tseary/BC-Matrix_Tetris_v1/README.md

# BC-Matrix_Tetris_v1
An Arduino tetris game for the Boldport Club Matrix
