tseary/BC-Matrix_Tetris_v1/(threads)

Thread 1 (2019-09-02):

High Score sound plays at power-on

tseary, 2019-09-02:
It's not a bug, it's a feature! Change it so that a power-on tune plays instead.

tseary, 2019-09-04:
This issue is worse now that pause has been implemented - the high score sound sometimes plays twice at power on.

tseary, 2019-09-05:
Magically fixed itself in pause branch.

Closed 2019-09-05.

Thread 2 (2019-09-02):

Game Over sound plays when turning sound on

tseary, 2019-09-02:
Following these steps:
1. Turn off sound by resetting with down button pressed
2. Play a game to the end until the screen fills
3. Turn on sound by resetting with down button released
Now the game-over sound plays inappropriately, because the sound controller was not reset.

tseary, 2019-09-04:
Possible solution: when "sound on" command is received, set the track to 0.

tseary, 2019-09-05:
Fixed.

Closed 2019-09-05.

Thread 4 (2019-09-02):

Pause

tseary, 2019-09-02:
Implement pause/unpause when the encoder button is clicked. Also requires pausing the music.

tseary, 2019-09-04:
Essential functionality is working: game and music stops while paused. Music continues where it left off when unpausing. Music restarts if game is reset while paused.
Remaining work is to add a pause screen.

tseary, 2019-09-05:
Completed. Game can now be paused by clicking the encoder button.

tseary, 2019-09-05:
There is no pause screen - that feature will not be implemented for now.

Closed 2019-09-05.

Thread 6 (2019-09-03):

Sound off doesn't work at power on

tseary, 2019-09-03:
To turn off sound, the the user currently has to power on, then hold down and press the reset button. It should be possible to power on with the down button held to turn off sound.

tseary, 2019-09-05:
Magically fixed itself in pause branch.

Closed 2019-09-05.

Thread 9 (2019-09-04):

Switch debouncing

tseary, 2019-09-04:
Switches have become less reliable with use and now require software debouncing. Perhaps need to throttle game loop.

tseary, 2019-09-05:
Fixed by adding 100 us delay in game loop.

Closed 2019-09-05.

Thread 10 (2019-12-10):

No ICSP header on controller

tseary, 2019-12-10:
Last time I had to solder bodge wires onto the microcontroller to bootload it. Never again!

Thread 13 (2019-12-18):

Serial interface

tseary, 2019-12-18:
Add a startup button code to enable serial (maybe by holding the encoder button).
Serial interface features should include setting the pixel brightness EEPROM.

tseary, 2021-06-19:
Startup button code has been implemented.

Thread 21 (2020-02-20):

Swap blocks

tseary, 2020-02-20:
Allow the user to save one block at a time, and swap it out with the current piece.

tseary, 2020-02-28:
It works!

Closed 2020-02-28.

Thread 26 (2021-05-14):

Down button bounce

tseary, 2021-05-14:
When the hardware down button bounces, after dropping one piece the next piece also drops. This is prevented in the software but it is not resilient to switch bounce. Add latency when releasing the switch before allowing the next piece to drop.

tseary, 2021-05-15:
Fixed.

Closed 2021-05-15.

Thread 27 (2021-05-15):

Button Longevity

tseary, 2021-05-15:
The tactile switches used in the game break down after a few months of regular play. Find a long-life button with the same footprint or redesign the button board to use a different class of switch.

tseary, 2021-05-15:
See Omron long life tactile switches: ‎B3F-4050‎ (3 million cycles) and B3F-5050 (10 million cycles).

tseary, 2021-06-23:
Buttons replaced with Omron B3F-5050, rated 10 million cycles. Usage metrics will tell how long they really last.

Closed 2021-06-23.

Thread 28 (2021-05-17):

Usage Metrics

tseary, 2021-05-17:
Measure usage and save in EEPROM. Measure one or more of:
- uptime
- games played
- button clicks (per switch)
- total encoder changes

tseary, 2021-06-19:
Tested and working.

Closed 2021-06-19.

Thread 29 (2021-05-17):

Blink using display driver

tseary, 2021-05-17:
The display driver is capable of displaying short videos and animations. Use this to draw blinking effects without re-sending the display contents multiple times.

tseary, 2021-06-20:
Blinking is rare in the program and not worth the effort.

Closed 2021-06-20.

Thread 30 (2021-05-20):

Louder Speaker

tseary, 2021-05-20:
The current design uses a 22 mm, 8 Ohm speaker for music/sound. The speaker is too quiet. Consider replacing it with a piezo transducer which is cheaper and consumes less power.

Thread 31 (2021-05-20):

Combine display and controller PCBs

tseary, 2021-05-20:
The current product has separate boards for display and control, which are mounted back-to-back. Combine all the circuitry of both onto a single double-sided board. The shape of this board should replace the vertical wooden component of the case.
