tseary/BC-Matrix_Tetris_v1/PCBs/Tetris_Controller_v1/Tetris_Controller_v1_schematic.pdf

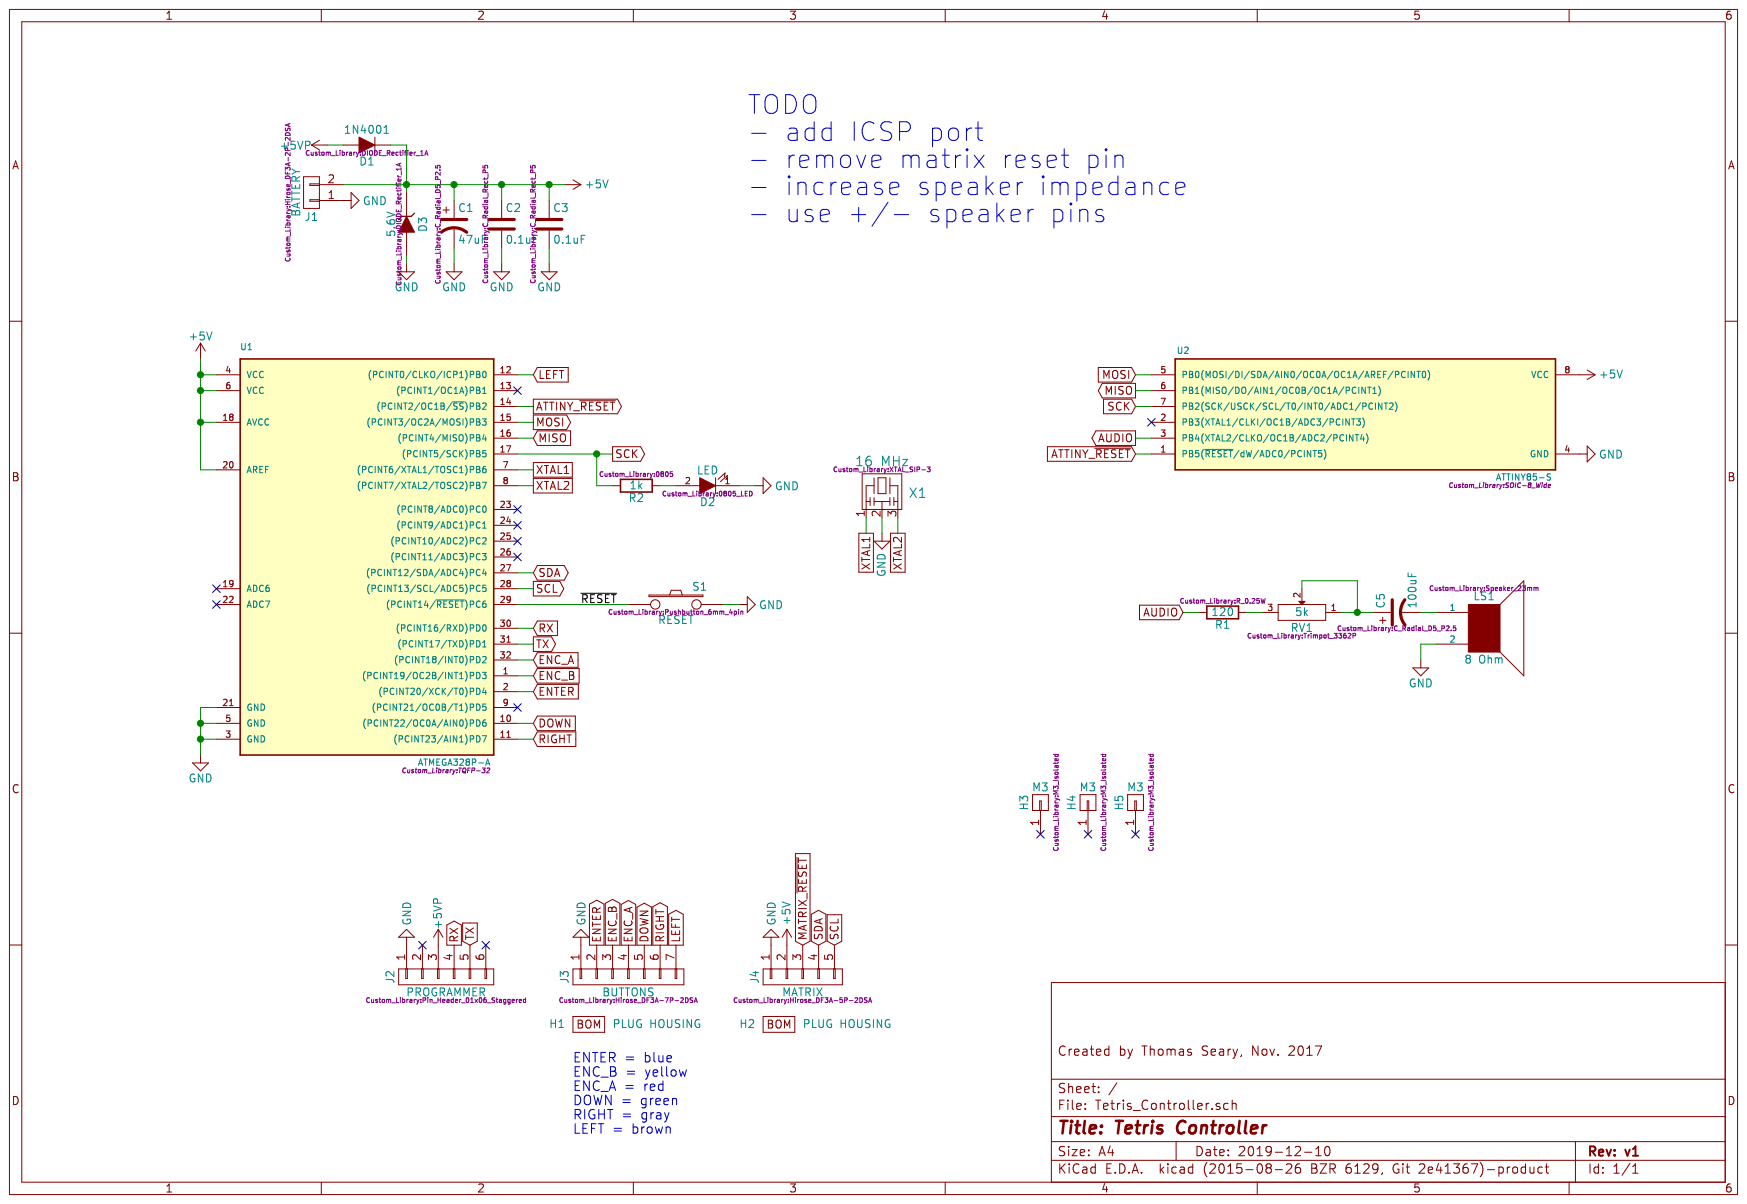
[picture p1: page 1]
