tseary/BC-Matrix_Tetris_v1/PCBs/Tetris_Buttons_v1/Tetris_Buttons.kicad_pcb

## KiCad design PCBs/Tetris_Buttons_v1/Tetris_Buttons.kicad_pcb (2019-12-10)

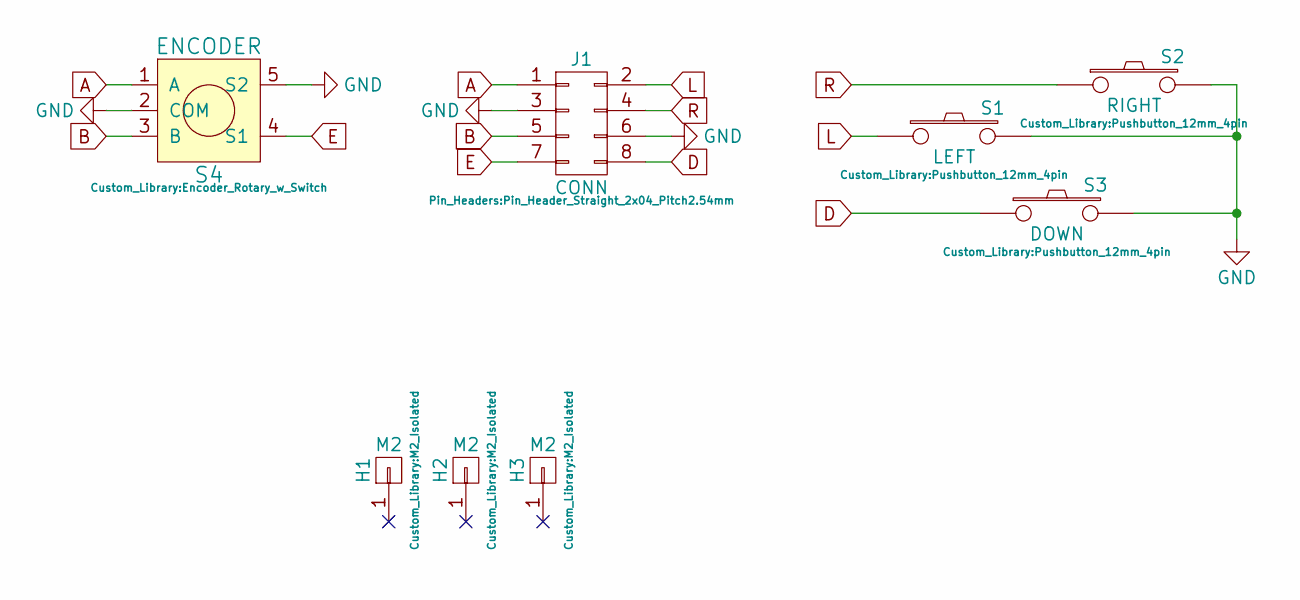
[picture p2: schematic Tetris_Buttons.sch]

Parts:
H1, H2, H3: M2; M2_Isolated
J1: CONN; Pin_Header_Straight_2x04_Pitch2.54mm
S1: LEFT; Pushbutton_12mm_4pin
S2: RIGHT; Pushbutton_12mm_4pin
S3: DOWN; Pushbutton_12mm_4pin
S4: ENCODER; Encoder_Rotary_w_Switch

Connections:
A: J1.1, S4.1 (A)
B: J1.5, S4.3 (B)
D: J1.8, S3.1
E: J1.7, S4.4 (S1)
GND: J1.3, J1.6, S1.2, S2.2, S3.2, S4.2 (COM), S4.5 (S2)
L: J1.2, S1.1
R: J1.4, S2.1

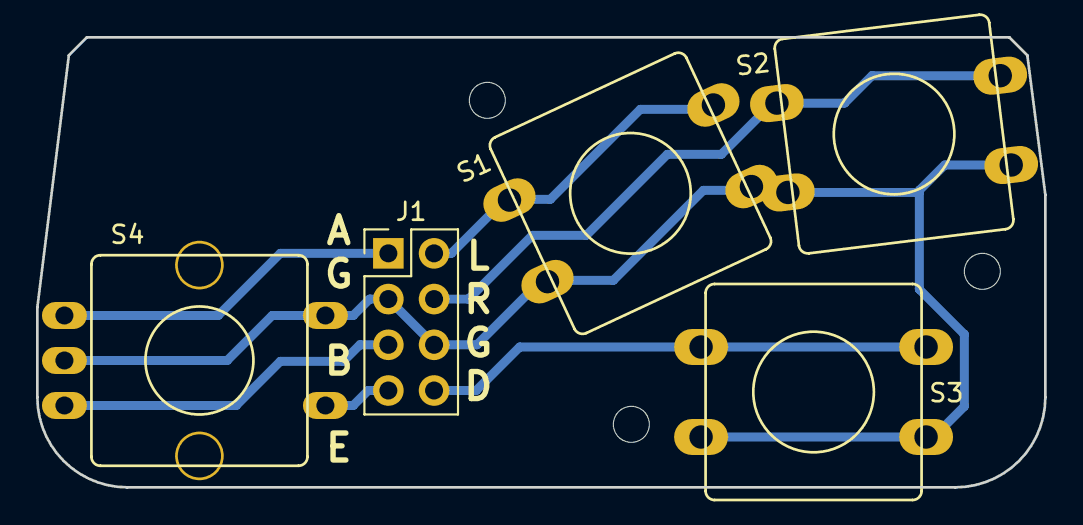
[picture p3: board Tetris_Buttons.kicad_pcb from above]

Board: 2 copper layers, 56.0 x 25.0 mm, 8 parts (0 on the bottom side), 7 nets.
