tseary/BC-Matrix_Tetris_v1/PCBs/Tetris_Controller_v1/Tetris_Controller.kicad_pcb

## KiCad design PCBs/Tetris_Controller_v1/Tetris_Controller.kicad_pcb (2019-12-10)

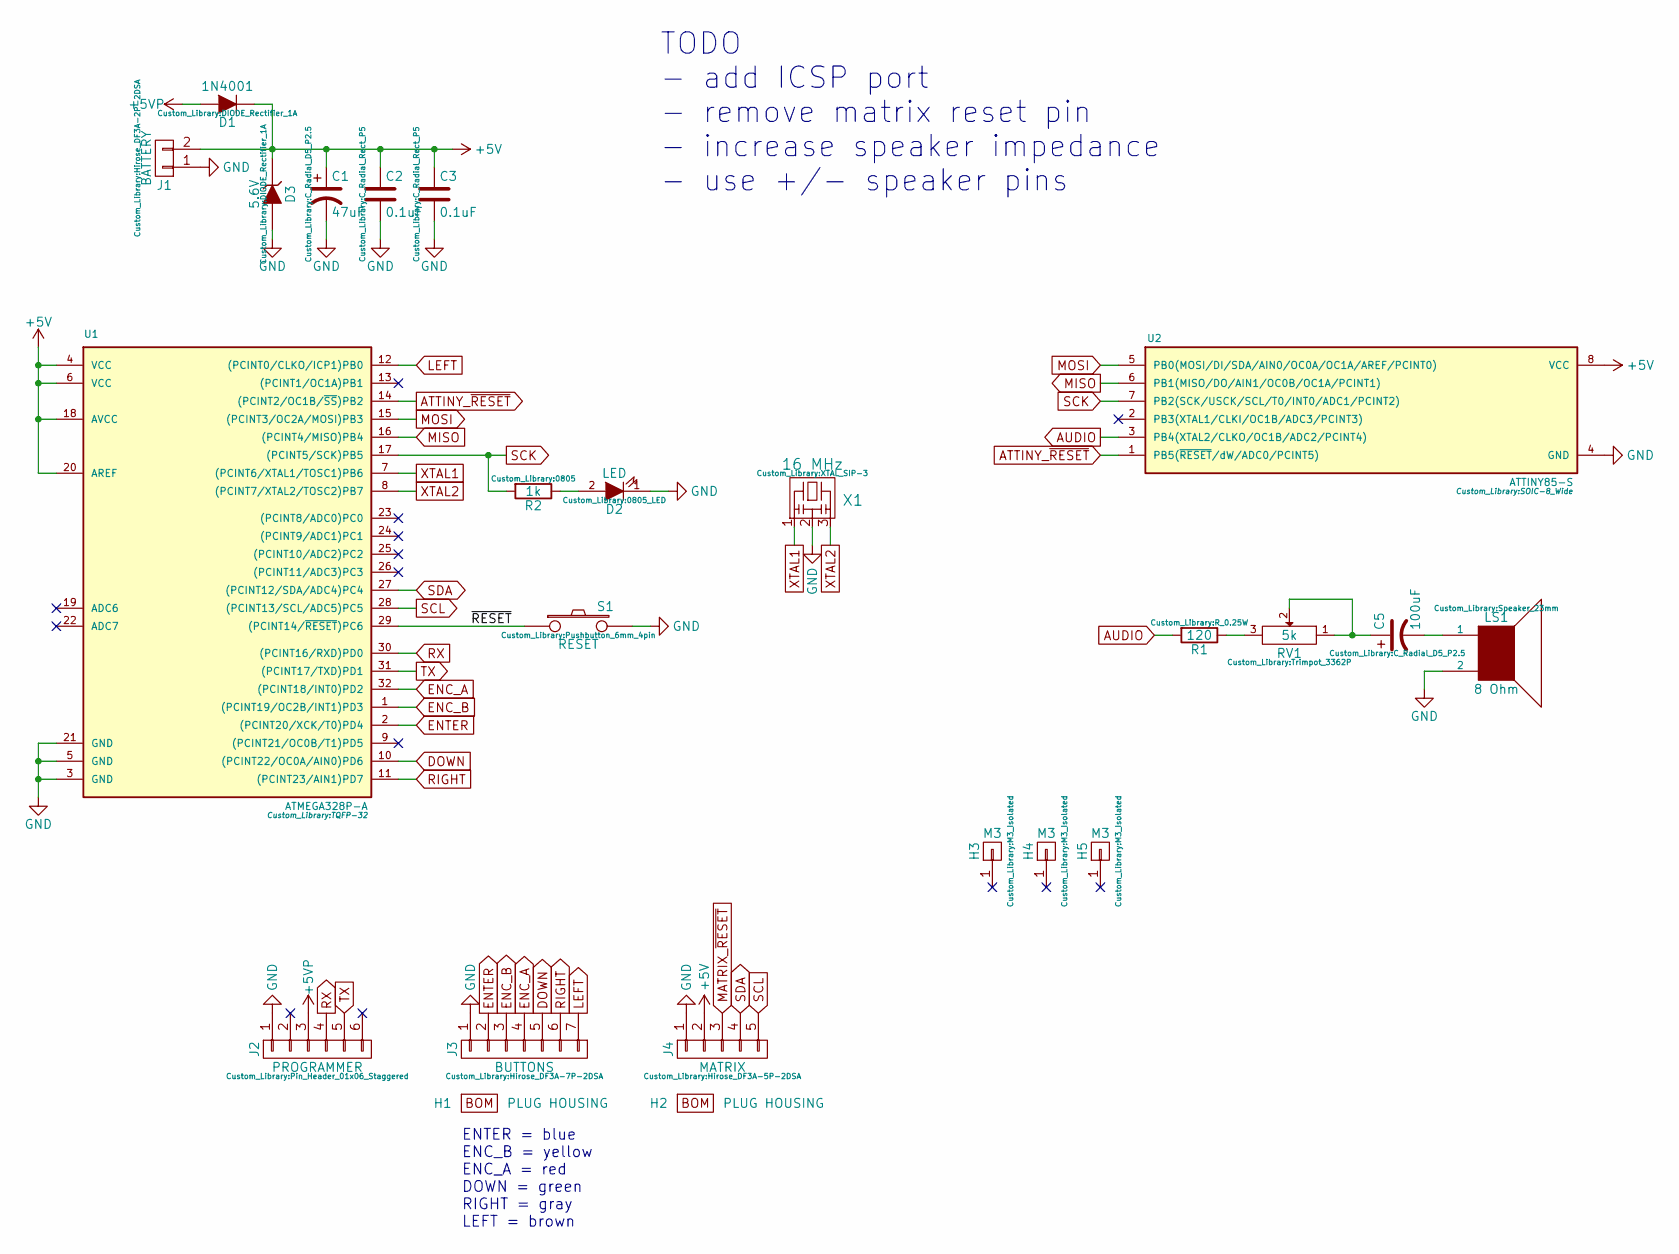
[picture p4: schematic Tetris_Controller.sch, Tetris Controller]

Parts:
C1: 47uF; C_Radial_D5_P2.5
C2, C3: 0.1uF; C_Radial_Rect_P5
C5: 100uF; C_Radial_D5_P2.5
D1: 1N4001; DIODE_Rectifier_1A
D2: LED; 0805_LED
D3: 5.6V; DIODE_Rectifier_1A
H1, H2: PLUG HOUSING
H3, H4, H5: M3; M3_Isolated
J1: BATTERY; Hirose_DF3A-2P-2DSA
J2: PROGRAMMER; Pin_Header_01x06_Staggered
J3: BUTTONS; Hirose_DF3A-7P-2DSA
J4: MATRIX; Hirose_DF3A-5P-2DSA
LS1: 8 Ohm; Speaker_23mm
R1: 120; R_0.25W
R2: 1k; 0805
RV1: 5k; Trimpot_3362P
S1: RESET; Pushbutton_6mm_4pin
U1: ATMEGA328P-A; TQFP-32
U2: ATTINY85-S; SOIC-8_Wide
X1: 16 MHz; XTAL_SIP-3

Connections:
+5V: C1.1, C2.1, C3.1, D1.1 (K), D3.1 (K), J1.2, J4.2, U1.4 (VCC), U1.6 (VCC), U1.18 (AVCC), U1.20 (AREF), U2.8 (VCC)
+5VP: D1.2 (A), J2.3
/~RESET: S1.1, U1.29 ((PCINT14/~RESET~)PC6)
ATTINY_~RESET: U1.14 ((PCINT2/OC1B/~SS~)PB2), U2.1 (PB5(~RESET~/dW/ADC0/PCINT5))
AUDIO: R1.2, U2.3 (PB4(XTAL2/CLKO/OC1B/ADC2/PCINT4))
DOWN: J3.5, U1.10 ((PCINT22/OC0A/AIN0)PD6)
ENC_A: J3.4, U1.32 ((PCINT18/INT0)PD2)
ENC_B: J3.3, U1.1 ((PCINT19/OC2B/INT1)PD3)
ENTER: J3.2, U1.2 ((PCINT20/XCK/T0)PD4)
GND: C1.2, C2.2, C3.2, D2.1 (K), D3.2 (A), J1.1, J2.1, J3.1, J4.1, LS1.2, S1.2, U1.3 (GND), U1.5 (GND), U1.21 (GND), U2.4 (GND), X1.2
LEFT: J3.7, U1.12 ((PCINT0/CLKO/ICP1)PB0)
MATRIX_~RESET: J4.3
MISO: U1.16 ((PCINT4/MISO)PB4), U2.6 (PB1(MISO/DO/AIN1/OC0B/OC1A/PCINT1))
MOSI: U1.15 ((PCINT3/OC2A/MOSI)PB3), U2.5 (PB0(MOSI/DI/SDA/AIN0/OC0A/OC1A/AREF/PCI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)
unnamed: C5.1, RV1.1, RV1.2
unnamed: C5.2, LS1.1
unnamed: D2.2 (A), R2.1
unnamed: R1.1, RV1.3
RIGHT: J3.6, U1.11 ((PCINT23/AIN1)PD7)
RX: J2.4, U1.30 ((PCINT16/RXD)PD0)
SCK: R2.2, U1.17 ((PCINT5/SCK)PB5), U2.7 (PB2(SCK/USCK/SCL/T0/INT0/ADC1/PCINT2))
SCL: J4.5, U1.28 ((PCINT13/SCL/ADC5)PC5)
SDA: J4.4, U1.27 ((PCINT12/SDA/ADC4)PC4)
TX: J2.5, U1.31 ((PCINT17/TXD)PD1)
XTAL1: U1.7 ((PCINT6/XTAL1/TOSC1)PB6), X1.1
XTAL2: U1.8 ((PCINT7/XTAL2/TOSC2)PB7), X1.3

Notes on the sheet:
ENTER = blue ENC_B = yellow ENC_A = red DOWN = green RIGHT = gray LEFT = brown
TODO - add ICSP port - remove matrix reset pin - increase speaker impedance - use +/- speaker pins

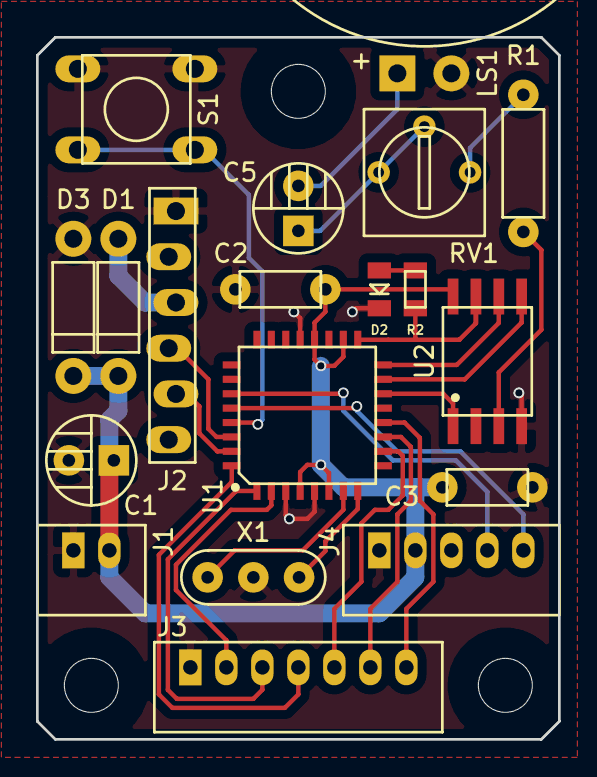
[picture p5: board Tetris_Controller.kicad_pcb from above]

Board: 2 copper layers, 29.0 x 39.0 mm, 22 parts (0 on the bottom side), 25 nets.
