tseary/BC-Matrix_Tetris_v1/Tetris_v2/Control.ino

// This file manages debouncing and detects button clicks.

#include <Encoder.h>

// Debouncing
const uint16_t DEBOUNCE_MICROS = 250;

// Buttons
const uint8_t L_BUTTON_PIN = 8; // brown wire
const uint8_t R_BUTTON_PIN = 7; // gray wire
const uint8_t D_BUTTON_PIN = 6; // green wire
const uint8_t E_BUTTON_PIN = 4; // blue wire (encoder button)

bool isLPressed = false;
bool isRPressed = false;
bool isDPressed = false;
bool isEPressed = false;

bool wasLPressed = false;
bool wasRPressed = false;
bool wasDPressed = false;
bool wasEPressed = false;

// Encoder
// The encoder pins are set to INPUT_PULLUP inside the Encoder class
const uint8_t ENCODER_A_PIN = 3; // yellow
const uint8_t ENCODER_B_PIN = 2; // red

Encoder encoder(ENCODER_A_PIN, ENCODER_B_PIN);

long lastPosition = 0,
nextPosition = 0;

void initializeControl() {
	// Active-low pushbuttons
	pinMode(L_BUTTON_PIN, INPUT_PULLUP);
	pinMode(R_BUTTON_PIN, INPUT_PULLUP);
	pinMode(D_BUTTON_PIN, INPUT_PULLUP);
	pinMode(E_BUTTON_PIN, INPUT_PULLUP);
}

// Reads the buttons etc.
void updateControl() {
	// Delay first to minimize latency between button read and resulting action
	delayMicroseconds(DEBOUNCE_MICROS);

	// Store previous button states
	wasLPressed = isLPressed;
	wasRPressed = isRPressed;
	wasDPressed = isDPressed;
	wasEPressed = isEPressed;

	// Read buttons
	isLPressed = !digitalRead(L_BUTTON_PIN);
	isRPressed = !digitalRead(R_BUTTON_PIN);
	isDPressed = !digitalRead(D_BUTTON_PIN);
	isEPressed = !digitalRead(E_BUTTON_PIN);

	updateEncoder();
}

bool isLClick() {
	return !wasLPressed && isLPressed;
}

bool isRClick() {
	return !wasRPressed && isRPressed;
}

bool isDClick() {
	return !wasDPressed && isDPressed;
}

bool isEClick() {
	return !wasEPressed && isEPressed;
}

bool isAnyClick() {
	return isLClick() || isRClick() || isDClick() || isEClick();
}

bool isLPress() {
	return isLPressed;
}

bool isRPress() {
	return isRPressed;
}

bool isDPress() {
	return isDPressed;
}

bool isEPress() {
	return isEPressed;
}

void updateEncoder() {
	lastPosition = nextPosition;

	// Encoder detents are four counts apart
	long encoderValue = encoder.read();
	nextPosition = (encoderValue + (encoderValue >= 0 ? 2 : -2)) / 4;
}

// Gets the change in encoder position
// Positive = clockwise
long getEncoderChange() {
	return nextPosition - lastPosition;
}
