tseary/BC-Matrix_Tetris_v1/(commit log)

2017-05-29 Stable
    Fixed curtain animation and minor bugs.
    [Display.ino]
2017-05-30 Added controller circuit documentation.
2017-06-21 Encoder test
    Experimental support for rotary encoder instead of joystick-up to rotate pieces.
2017-06-28 Created Pitch and Value enums
    Separated note pitches from frequencies in Hertz, and values from durations in millis.
2017-06-28 Added SPI pin numbers
2017-07-16 Updates for final hardware
    Changed next-level music command from 0x11 to 0x01.
    Changed timing in badTone() to get more accurate frequency.
    Removed nav switch support and replaced with L/R/D/E buttons.
    [Command.ino, Control.ino]
2017-08-11 EEPROM random seed
    WIP - untested
    Added persistent random seed in EEPROM for more randomness between power cycles.
    Also added high score fields (unused for now).
2017-08-11 Documentation
    Added descriptions of game board geometry and some functions.
2017-08-14 Flashing high score
    Added flashing high score.
    Fixed backwards 5 in five-wide digits.
    [Display.ino]
2017-12-07 Second unit tweaks
    Added differential speaker drive for music controller.
    Added E+L+R button combo to clear high score at power up.
    Changed brightness for stock red LEDs.
2017-12-07 Power-on mute and brightness
    Fixed invalid COMMAND_SOUND_OFF value.
    Implemented brightness adjustment and EEPROM.
    Added DEBUG_SERIAL define, to toggle serial activity.
    Added compile timestamp.
    Started adding game over music support.
    [Command.ino, Control.ino, Display.ino, Music.ino, Song.ino]
2017-12-07 Multi-track music WIP
2017-12-07 Multi-track music code cleanup
    It compiles now, but is untested.
2017-12-07 Music finished
    Tested and fine-tuned music functions for game over and high score.
    Changed game over sound to ascending minor scale.
    Added track change check in badToneDifferential() to allow breaking mid-note.
2017-12-08 Release
    Fixed encoder math that caused dead spot at zero.
    Turned off debug serial.
    [Control.ino]
2018-03-03 Multi-colour brightness correction
    Implemented partial screen dimming for a display with mixed LEDs.
    [Display.ino]
2018-06-21 Tweaks
    Delay before sending first music command.
    Debug output of encoder reading.
2019-09-03 Fixed top garbage
    Removed setting tetramino type to "none" in gameOver(). Attempting to draw invalid tetramino results in garbage on screen.
    [Tetris_v2.ino]
2019-09-03 Rudimentary pause
    Game pauses/unpauses when E button is clicked. Music does not pause yet. Screen freezes during pause.
2019-09-04 Fixed music restart on level up
    [TetrisMusic.ino]
2019-09-05 Fixed Game Over sound when sound is turned on
    [Command.ino]
2019-09-05 Switch debounce
    Added 100 us delay in game loop to debounce switches. Tested at level 13 to ensure responsiveness.
2019-09-05 Tweaks
    Can now unpause with any input - not just encoder button.
    Moved debounce delay out of main file into Control.ino.
2019-09-05 Low power pause
    Added low power delay during pause and brightness adjustment. Reduced display current while paused.
2019-09-05 Music low power
    Added low-power sleep for music processor when sound is off (or silenced), but not when paused.
2019-09-06 Music reset
    Reset the music controller at power on, to ensure no spurious sounds are played. Also lengthened delay before first music command.
    [Music.ino, Tetris_v2.ino]
2019-09-07 Comment changes
    Removed obsolete comments describing navigation switch.
2019-12-10 Added KiCad PCBs
    Added the Controller v1 and Buttons v1 KiCad designs. These are provided for reference only and are not recommended for production.
    [Tetris_Buttons.kicad_pcb, Tetris_Buttons.sch, Tetris_Controller.csv, Tetris_Controller.kicad_pcb, Tetris_Controller.sch]
2019-12-18 Changed EEPROM addresses to preserve screen settings
    This update will not show the old high score, but it also won't be overwritten.
    [Tetris_v2.ino]
2019-12-18 Added separate high score- and factory-reset codes.
    Made L+D button code do a high score reset, and L+D+R do a factory reset.
    After a factory reset, the game displays "RST" and goes to sleep forever.
    [Tetris_v2.ino]
2020-02-19 Swap tetraminos by pressing L+R
    Added the ability to save and recall tetraminos. One tetramino is stored at a time and can be swapped with the active piece by pressing L and R together.
    [Control.ino, Tetris_v2.ino]
2020-02-20 Tetramino collision with mask
    Created FIELD_MASK constants. Added optional mask argument to isTetraminoCollision() for deteting collisions only in certain parts of the field.
    [Control.ino, Display.ino, Tetris_v2.ino]
2020-02-20 Replace rotation collision detection
    Used resolveCollision() when rotating pieces.
    [Tetris_v2.ino]
2020-02-20 Reset stored piece
    Clear the stored piece in newGame().
    Moved the center of rotation for J and L tetraminos for even better tucking.
    [Tetramino.h, Tetris_v2.ino]
2021-05-12 Reduced curtain density
    Changed fill pattern to 1/3 diagonal stripes to reduce power consumption.
2021-05-13 High score groups
    Implemented separate groups of high scores for swap-piece players and non-swap-piece players.
    [Tetris_v2.ino]
2021-05-14 EEPROM for sound settings
    Added one byte in EEPROM for sound settings. Now holding the down button while turning on toggles sound rather than turning it off for one game only. This will save battery power for players who typically play without sound.
2021-05-14 Inverted sound setting
    Changed the definition of the sound setting in EEPROM so that 0 = sound on. This is the factory default.
    [Tetris_v2.ino]
2021-05-15 Debounce D button
    Added debounce counter to the D button. The canDropPiece flag is only reset after the D button has been released for 4 consecutive input cycles.
    [Tetris_v2.ino]
2021-05-15 Added clear bonus
    The player now scores double points for any piece that clears the board.
2021-06-18 Serial interface
    Added serial interface to print out usage metrics. Created updateControlAndUsage() for tidiness.
2021-06-19 Reset usage metrics
    Added startup button combination (L+D+E) to reset usage metrics EEPROM.
    [Tetris_v2.ino]
2021-06-20 Pause text
    Hide the board and display the text "PAUSE" while paused. Added separate picture for special text, and removed blank picture.
2021-06-23 Fix numbers not displayed
    Moved some text drawing functions to Display.ino. Added missing drawBoard() call in drawNumber().
    [Display.ino, Tetris_v2.ino]
